Novadriann/PKM---Margorejo/DESIGN MEKANIS/margorejo-Assembly final.step

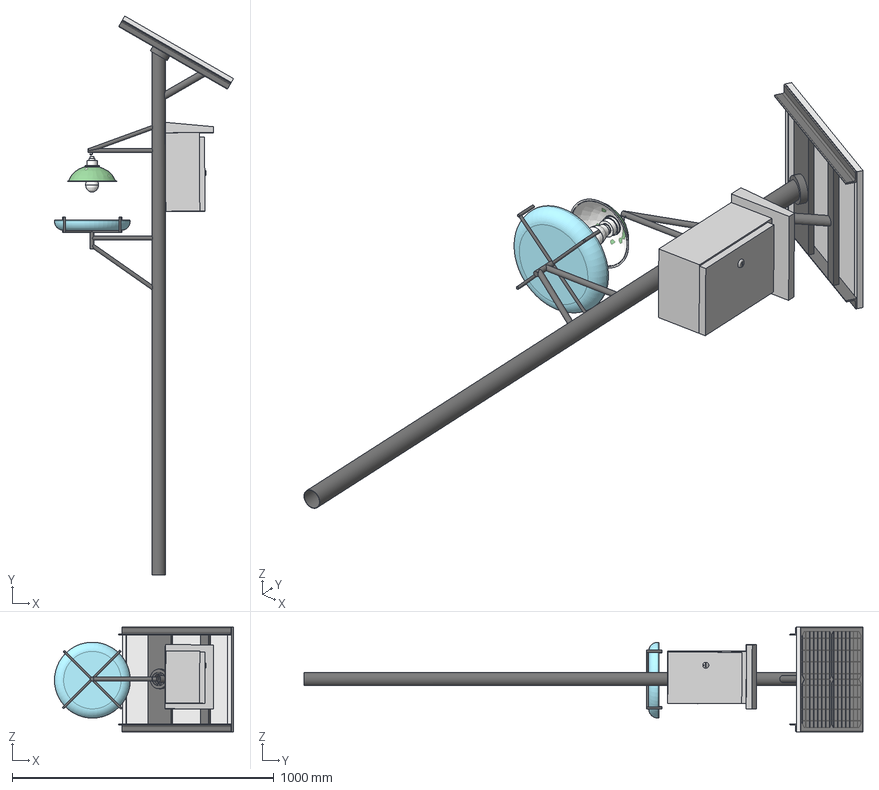
[picture p1: CAD file, 2026-10-15]
DESIGN MEKANIS/margorejo-Assembly final.step
684.8 x 2137.5 x 400.0 mm
tiang
ISO 657-1 - L30x30x4-480
ISO 657-1 - L30x30x4-480_1
ISO 1035/3 - 35 x 15 - 340
ISO 1035/3 - 100 x 15 - 340
Solar panel
ISO 12633-2 - 26.9 x 2.6 - 200
