Novadriann/PKM---Margorejo/DESIGN MEKANIS/margorejo-Mounting Cable Gland.stp

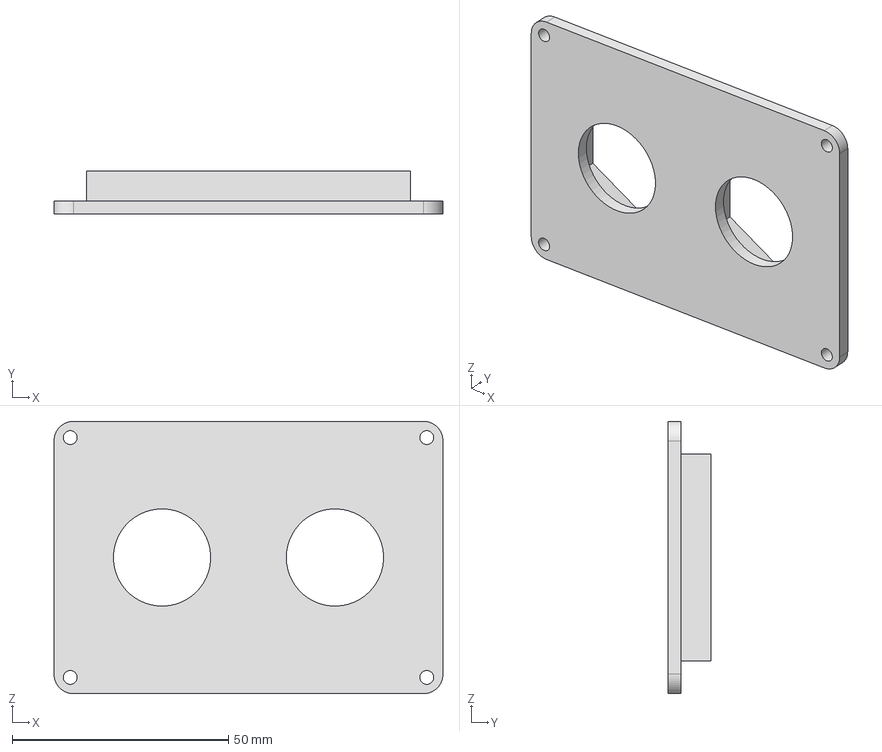
[picture p2: CAD file, 2026-10-15]
DESIGN MEKANIS/margorejo-Mounting Cable Gland.stp
90.0 x 10.0 x 63.0 mm
