Novadriann/PKM---Margorejo/DESIGN MEKANIS/margorejo_Dudukan Aki.step

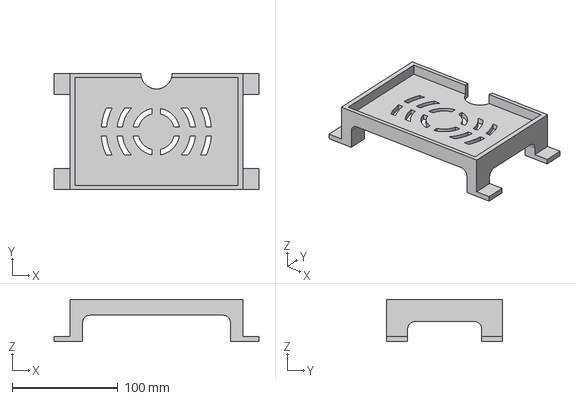
[picture p3: CAD file, 2026-10-15]
DESIGN MEKANIS/margorejo_Dudukan Aki.step
194.0 x 110.0 x 40.0 mm
