Novadriann/PKM---Margorejo/DESIGN MEKANIS/margorejo-Cover Soil Moisture.stl

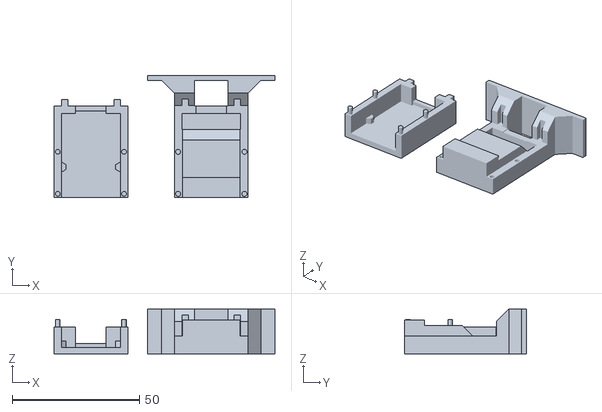
[picture p4: CAD file, 2026-10-15]
DESIGN MEKANIS/margorejo-Cover Soil Moisture.stl
86.7 x 48.0 x 17.6
