Novadriann/PKM---Margorejo/DESIGN MEKANIS/margorejo-Mounting PCB.step

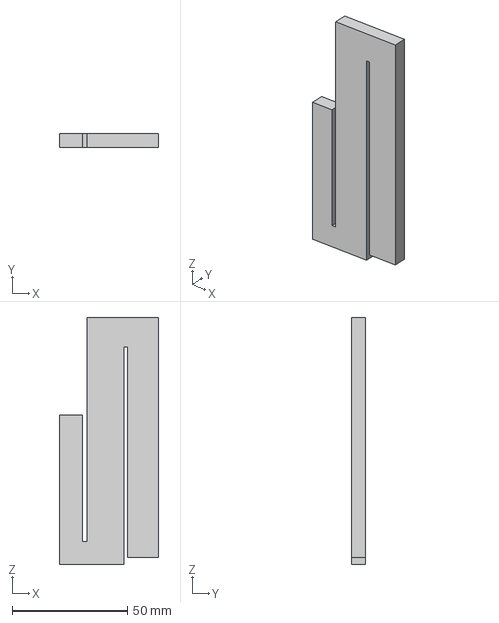
[picture p5: CAD file, 2026-10-15]
DESIGN MEKANIS/margorejo-Mounting PCB.step
43.0 x 6.00 x 107.0 mm
