Novadriann/PKM---Margorejo/DESIGN MEKANIS/margorejo-Mounting INA226.stl

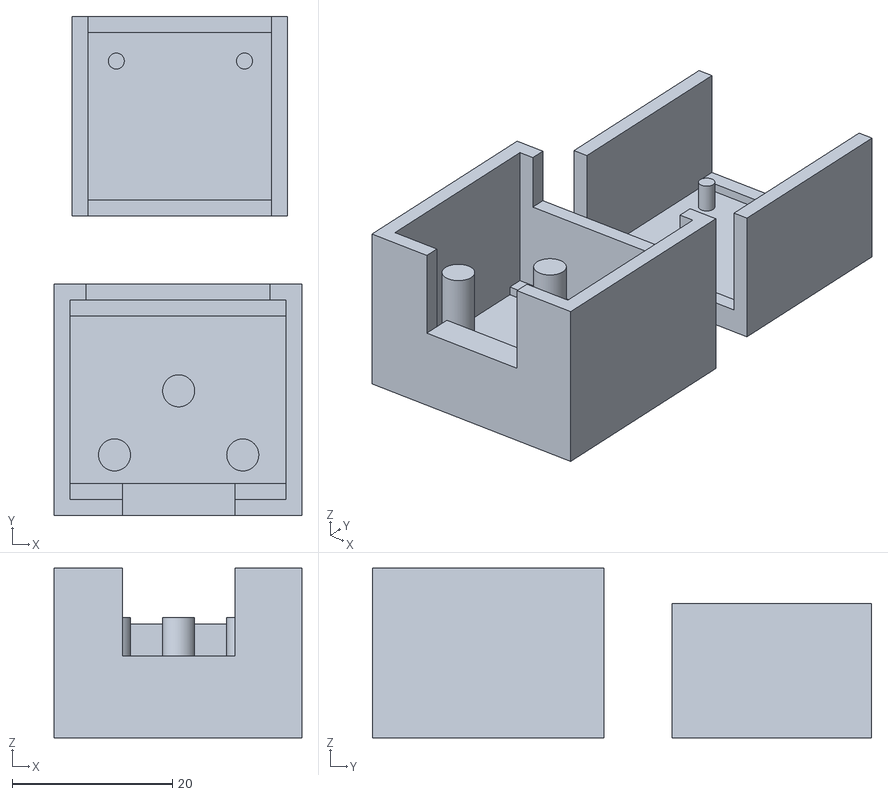
[picture p6: CAD file, 2026-10-15]
DESIGN MEKANIS/margorejo-Mounting INA226.stl
30.9 x 62.3 x 21.2
