Novadriann/PKM---Margorejo/DESIGN MEKANIS/margorejo-Mounting DHT.stl

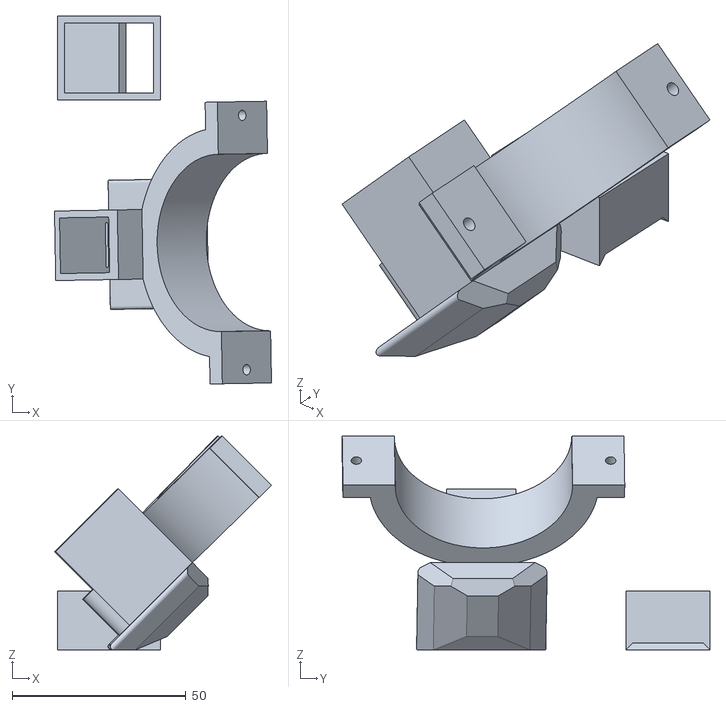
[picture p7: CAD file, 2026-10-15]
DESIGN MEKANIS/margorejo-Mounting DHT.stl
62.4 x 105.8 x 61.5
