Novadriann/PKM---Margorejo/(list of files, cad)

Other CAD files:
DESIGN MEKANIS/Margorejo_Clamp_A2L.gcode.3mf
