Novadriann/PKM---Margorejo/Buku_Panduan_Wiring_NURTURE_Margorejo.docx

PROGRAM PENGABDIAN KEPADA MASYARAKAT (PKM) 2026
UNIVERSITAS GADJAH MADA — MARGOREJO, SLEMAN

BUKU PANDUAN TEKNIS & WIRING
SISTEM PERTANIAN CERDAS MANDIRI ENERGI
"NURTURE"

Pedoman Operasional, Integrasi Catu Daya Bertingkat, Perkabelan Sensor, dan Perawatan Mandiri untuk Petani & Teknisi Lapangan

Parameter | Keterangan
Nama Sistem | NURTURE: Smart Agriculture Mandiri Energi Berbasis IoT & Web
Lokasi Kegiatan | Lahan Pertanian Kalurahan Margorejo, Kapanewon Tempel, Sleman, D.I. Yogyakarta
Dosen Pembimbing | Nur Achmad Sulistyo Putro, S.Si., M.Cs., Ph.D.
Platform Pengendali | ESP32-S3 DevKitC-1 N16R8V Dual Type-C (Dual-Core 240MHz, Wi-Fi/BLE)

BAB I. PENGENALAN ARSITEKTUR SISTEM & DESAIN PCB BERTINGKAT

Sistem NURTURE dirancang secara khusus untuk bekerja secara mandiri (off-grid) di area persawahan Margorejo yang minim jangkauan listrik PLN. Agar sistem memiliki daya tahan tinggi terhadap gangguan lingkungan, interferensi elektromagnetik, dan cuaca ekstrem, perangkat keras pengendali dibangun menggunakan konsep PCB Bertingkat (Stack PCB Architecture) 2 Tingkat.

1.1 Filosofi dan Alasan Desain PCB Bertingkat (Dual-Tier)

Di dalam kotak panel kendali pertanian terdapat dua jenis perangkat dengan karakteristik listrik yang sangat bertolak belakang:
1. Perangkat Logika & Sensor Mikro: Membutuhkan tegangan stabil (3.3V dan 5V), arus sangat kecil, dan sensitif terhadap noise listrik.
2. Perangkat Daya & Aktuator Beban: Membutuhkan arus besar (tegangan 12V DC), menarik arus hentakan saat menyala (seperti motor kipas, relay, dan solenoid valve), serta menghasilkan tegangan kejut balik (back-EMF).

Jika kedua kelompok komponen ini diletakkan pada satu keping PCB biasa, hentakan listrik dari pompa/valve akan langsung mengacaukan pembacaan sensor tanah atau menyebabkan chip mikrokontroler hang/restart (dikenal sebagai fenomena Brownout). Oleh karena itu, sistem memisahkan fisiknya menjadi dua tingkat:

💡 INFORMASI TEKNIS: Mengapa PCB Dibagi Menjadi Dua Tingkat?
Tingkat Bawah (Lower Tier) dikhususkan sebagai Regulator & Jalur Daya Arus Tinggi (12V, 5V, 3.3V).
Tingkat Atas (Upper Tier) dikhususkan sebagai Pusat Pemrosesan Data & Antarmuka Sensor Mikro.
Pemisahan ini menjamin kestabilan modul ESP32-S3 dan sensor NPK 7-in-1 dari gangguan motorik aktuator.

1.2 PCB Tingkat Bawah (Lower Tier — Power & Step-Down Board)

PCB tingkat bawah berfungsi sebagai 'jantung distribusi energi' yang menerima arus listrik DC dari Baterai VRLA 12V 12Ah yang diisi oleh Panel Surya (PLTS) melalui Solar Charge Controller (SCC). Di tingkat bawah ini terpasang modul-modul penurun tegangan (Step-Down DC-DC):
• Jalur Rel 12V DC: Menyalurkan listrik langsung dari baterai ke aktuator berat (Solenoid Valve 12V, Lampu UV Trap 12V, dan Kipas 12V).
• Jalur Rel 5V DC (Step-Down 12V ke 5V): Mengubah 12V baterai menjadi 5V teregulasi (kapasitas 3A) untuk mencatu pin 5V ESP32-S3, modul konverter MAX485 RS485, modul koil relay, dan sensor DHT22.
• Jalur Rel 3.3V DC (Step-Down 12V ke 3.3V): Menyediakan tegangan kerja murni 3.3V untuk pin logika sensitif.
• Titik Common Ground (GND Bersama): Seluruh kutub negatif (GND) dari 12V, 5V, dan 3.3V diikat menjadi satu bidang ground bersama (star ground) agar referensi tegangan tidak melayang.

1.3 PCB Tingkat Atas (Upper Tier — Controller & Sensor Interface)

PCB tingkat atas berfungsi sebagai 'otak dan pusat saraf' pengendali otomatisasi. Komponen-komponen utama yang terpasang di PCB atas meliputi:
• Soket Mikrokontroler ESP32-S3 DevKitC-1 N16R8V (16MB Flash, 8MB PSRAM).
• IC / Modul Transceiver RS485 (U2 - MAX485) untuk membaca protokol industri Modbus RTU pada sensor NPK 7-in-1.
• Tiga Unit Driver Transistor NPN (Q1, Q2, Q3) beserta resistor basis 2kΩ (R1, R2, R3) sebagai sakelar penyala relay.
• Deretan Soket Terminal Sensor: JST-XH dan Screw Terminal untuk Sensor NPK, 3x Probe Kelembapan Tanah, 3x Sensor DHT22, Sensor Cahaya LDR, dan RTC DS3231.
• Soket Interkoneksi Daya Vertikal: Menerima rel 12V, 5V, dan 3.3V dari PCB tingkat bawah.

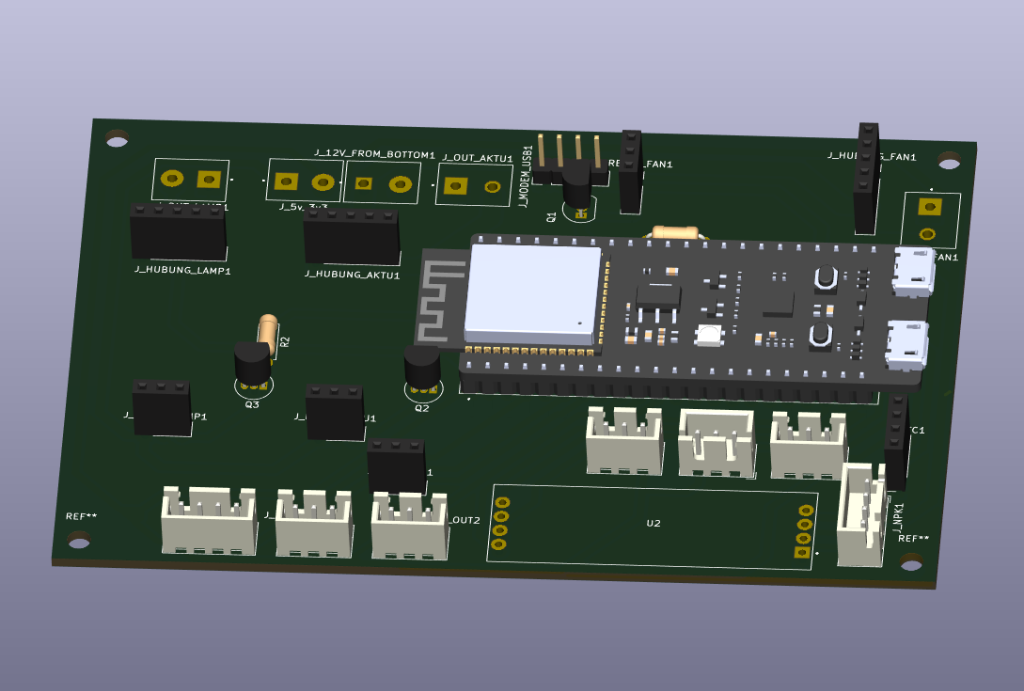
[picture p8: figure]

Gambar 1.1: Visualisasi 3D PCB Tingkat Atas (Main Controller & Sensor Interface Board)

BAB II. PANDUAN WIRING & TERMINAL KONEKTOR PCB ATAS

Bab ini memandu secara rinci letak setiap konektor, nomor pin, warna kabel standar, serta fungsi sambungannya ke perangkat luar. Pastikan teknisi lapangan atau kelompok tani membaca tabel ini sebelum mencolokkan kabel sensor atau beban.

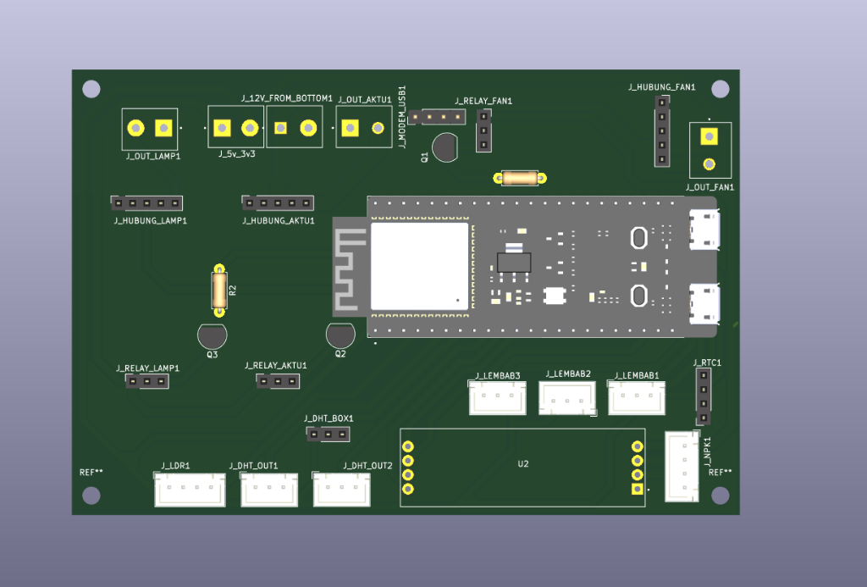
[picture p9: figure]

Gambar 2.1: Tata Letak Konektor dan Silkscreen PCB Tingkat Atas (Tampak Atas)

2.1 Tabel Konektor Interkoneksi Daya (Dari PCB Bawah ke Atas)

Tegangan kerja didistribusikan dari PCB tingkat bawah melalui dua blok konektor vertikal:

Nama Konektor | Pin | Nama Sinyal | Tegangan | Keterangan Fungsi
J_12V_FROM_BOTTOM1 | Pin 1 | +12V | +12 Volt DC | Masukan daya utama dari Baterai PLTS (tingkat bawah)
J_12V_FROM_BOTTOM1 | Pin 2 | GND | 0 Volt (Ground) | Kutub negatif / Ground daya utama
J_5v_3v3 | Pin 1 | +5V | +5.0 Volt DC | Keluaran Step-Down 5V dari tingkat bawah (untuk ESP & Sensor)
J_5v_3v3 | Pin 2 | +3V3 | +3.3 Volt DC | Keluaran Step-Down 3.3V dari tingkat bawah
J_5v_3v3 | Pin 3 | GND | 0 Volt (Ground) | Jalur Ground logika bersama
J_5v_3v3 | Pin 4 | GND | 0 Volt (Ground) | Jalur Ground logika bersama (paralel)

2.2 Tabel Konektor Sensor Tanah, Nutrisi, dan Lingkungan

Seluruh sensor pertanian dihubungkan ke deretan konektor putih di sisi bawah dan kanan PCB:

Kode Soket | Pin | Nama Jalur | GPIO ESP32 | Keterangan & Warna Kabel Standar
J_NPK1 | Pin 1 | VCC (+5V/12V) | — | Catu daya sensor NPK 7in1 (Kabel COKELAT)
J_NPK1 | Pin 2 | GND | — | Kutub negatif sensor NPK (Kabel HITAM)
J_NPK1 | Pin 3 | RS485 A (+) | Via IC U2 | Data Modbus Positif / Non-Inverting (Kabel KUNING)
J_NPK1 | Pin 4 | RS485 B (-) | Via IC U2 | Data Modbus Negatif / Inverting (Kabel BIRU)
J_LEMBAB1 | 1, 2, 3 | VCC, OUT, GND | GPIO 10 (ADC) | Probe Kelembapan Tanah Analog 1 (Kapasitif)
J_LEMBAB2 | 1, 2, 3 | VCC, OUT, GND | GPIO 11 (ADC) | Probe Kelembapan Tanah Analog 2 (Kapasitif)
J_LEMBAB3 | 1, 2, 3 | VCC, OUT, GND | GPIO 12 (ADC) | Probe Kelembapan Tanah Analog 3 / Cadangan
J_DHT_BOX1 | 1, 2, 3 | VCC, DATA, GND | GPIO 7 | Sensor DHT22 Suhu & Kelembapan Kotak Panel
J_DHT_OUT1 | 1, 2, 3 | VCC, DATA, GND | GPIO 6 | Sensor DHT22 Cuaca Lingkungan Luar 1
J_DHT_OUT2 | 1, 2, 3 | VCC, DATA, GND | GPIO 16 | Sensor DHT22 Cuaca Lingkungan Luar 2
J_LDR1 | 1, 2, 3, 4 | VCC, OUT, GND | GPIO 4 (ADC) | Sensor Cahaya Matahari LDR (Intensitas Radiasi)
J_RTC1 | 1, 2 | VCC, GND | — | Catu daya Modul DS3231 Waktu Presisi (5V)
J_RTC1 | Pin 3 | SDA (Data I2C) | GPIO 8 | Jalur data I2C RTC DS3231
J_RTC1 | Pin 4 | SCL (Clock I2C) | GPIO 9 | Jalur clock I2C RTC DS3231

⚠️ PERINGATAN KESELAMATAN: Kabel Modbus RS485 Sensor NPK 7-in-1
Warna kabel standar pabrik sensor NPK 7in1 adalah:
• Cokelat: VCC (+5V / +12V)
• Hitam: GND (Ground)
• Kuning: Pin A (RS485+)
• Biru: Pin B (RS485-)
JANGAN SAMPAI TERBALIK antara kabel A (Kuning) dan B (Biru) karena akan menyebabkan kode error pembacaan NPK di layar monitor.

2.3 Rangkaian Penggerak Aktuator (Driver Transistor & Relay)

Untuk melindungi ESP32-S3 dari tarikan arus koil relay dan lonjakan tegangan, PCB atas dilengkapi sirkuit sakelar transistor NPN (BJT). Pin GPIO mikrokontroler tidak menyalakan relay secara langsung, melainkan mengalirkan arus kecil melalui resistor 2kΩ ke basis transistor, yang kemudian men-trigger jalur relay eksternal.

Aktuator Beban | Pin GPIO ESP32 | Resistor & Transistor | Header ke Modul Relay | Terminal Daya Output
Kipas Pendingin Kotak (Fan) | GPIO 39 | R1 (2kΩ) & Q1 (NPN) | J_RELAY_FAN1 (3 Pin) | J_OUT_FAN1 & J_HUBUNG_FAN1 (12V)
Lampu UV Perangkap Hama | GPIO 15 | R2 (2kΩ) & Q3 (NPN) | J_RELAY_LAMP1 (3 Pin) | J_OUT_LAMP1 & J_HUBUNG_LAMP1 (12V)
Solenoid Valve (Penyiraman) | GPIO 5 | R3 (2kΩ) & Q2 (NPN) | J_RELAY_AKTU1 (3 Pin) | J_OUT_AKTU1 & J_HUBUNG_AKTU1 (12V)

2.4 Skematik Elektronika Lengkap (KiCad)

Berikut adalah gambar skema pengkabelan elektronik menyeluruh dari sistem PCB tingkat atas yang dirancang menggunakan KiCad EDA (pengabdian.kicad_sch):

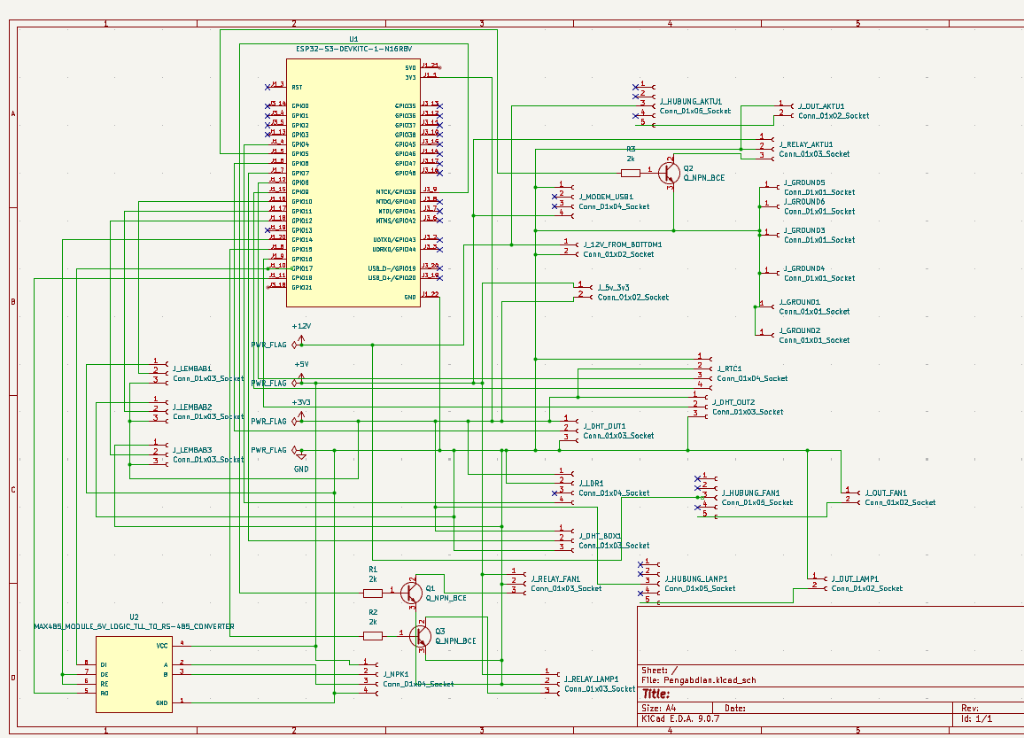
[picture p10: figure]

Gambar 2.2: Skematik Sirkuit Elektronika Lengkap PCB Tingkat Atas (KiCad EDA)

BAB III. SISTEM CATU DAYA MANDIRI ENERGI (PLTS & PCB BAWAH)

Sistem NURTURE beroperasi sepenuhnya menggunakan energi terbarukan tenaga surya. Stabilitas operasional sangat bergantung pada kualitas perakitan kelistrikan dari panel surya hingga masuk ke PCB tingkat bawah.

3.1 Diagram Alur Energi Listrik Sistem

1. Panel Surya (Photovoltaic): Mengonversi radiasi sinar matahari menjadi energi listrik DC.
2. Solar Charge Controller (SCC): Mengatur pengisian daya baterai (mencegah overcharge saat siang dan overdischarge saat malam).
3. Baterai VRLA 12V 12Ah: Menyimpan cadangan energi yang sanggup menghidupkan seluruh sistem selama lebih dari 3 hari berawan/hujan tanpa matahari.
4. Sensor Arus Dual INA226 (I2C):
• Modul 1 (Alamat I2C 0x44): Mengukur arus dan daya pengisian dari SCC ke Baterai (Charging Current).
• Modul 2 (Alamat I2C 0x45): Mengukur arus dan konsumsi daya aktual yang ditarik oleh seluruh sistem (Load Current).
5. PCB Tingkat Bawah (Regulator Board): Mengambil input 12V dari baterai dan memecahnya menjadi rel 12V, 5V, dan 3.3V.
6. PCB Tingkat Atas: Menerima tegangan bersih untuk ESP32-S3 dan sensor.

3.2 Konfigurasi Modul Step-Down di PCB Tingkat Bawah

Di PCB tingkat bawah dipasang modul regulator efisiensi tinggi (Buck Converter DC-DC, misalnya tipe LM2596 atau XL4015):
• Modul Step-Down 5V: Disetel tepat pada tegangan keluaran 5.05V - 5.10V DC. Modul ini wajib mampu mengeluarkan arus konstan minimal 2.5 hingga 3.0 Ampere. Arus ini diperlukan saat ESP32-S3 memancarkan sinyal radio Wi-Fi sambil mengaktifkan relay.
• Modul Step-Down 3.3V: Disetel tepat pada tegangan keluaran 3.30V DC untuk keperluan suplai logika sensor bertegangan rendah.

⚠️ PERINGATAN KESELAMATAN: Pedoman Pemasangan Kabel Power (Mencegah Kebakaran & Drop Tegangan)
1. Gunakan kabel serabut tembaga tebal (minimal ukuran AWG 18-20 atau penampang 0.75 mm²) untuk menghubungkan aki, SCC, dan input PCB bawah. Jangan pernah menggunakan kabel jumper tipis untuk jalur daya utama!
2. Pasang Fuse / Sekring Pengaman DC (tipe tabung kaca atau sekring tancap otomotif ukuran 3A - 5A) pada kutub positif kabel aki menuju sistem sebagai proteksi korsleting.
3. Pastikan baut terminal aki dan terminal blok PCB terkunci rapat. Baut kendor dapat menimbulkan percikan api dan membuat tegangan drop.

BAB IV. LOGIKA OPERASIONAL & ATURAN OTOMASI SISTEM

Seluruh keputusan otomatisasi dikerjakan secara mandiri di dalam chip ESP32-S3 setiap detik tanpa memerlukan koneksi internet (sistem tetap menyiram dan menyalakan lampu meskipun jaringan Wi-Fi sedang terputus).

4.1 Otomasi Penyiraman Lahan (Smart Solenoid Valve)

Penyiraman tanaman dilakukan secara terjadwal berdasarkan jam presisi dari modul RTC DS3231:
• Jadwal Pagi: Solenoid valve terbuka otomatis tepat pada pukul 07:00:00 WIB dan menyiram selama 10 menit hingga pukul 07:10:00 WIB.
• Jadwal Sore: Solenoid valve terbuka otomatis tepat pada pukul 17:20:00 WIB dan menyiram selama 10 menit hingga pukul 17:30:00 WIB.
• Proteksi Batas Maksimum (Safety Timeout 15 Menit): Sistem dilengkapi fail-safe otomatis. Jika karena suatu gangguan program atau sensor valve menyala lebih dari 15 menit, mikrokontroler akan memutus daya valve secara paksa untuk mencegah kebanjiran lahan atau terbakarnya kumparan solenoid valve.

4.2 Otomasi Kipas Pendingin Boks Panel (Smart Cooling Fan)

Boks panel yang diletakkan di tengah sawah terbuka sangat rentan mengalami panas berlebih akibat terik matahari. Sistem melindungi komponen elektronik dengan aturan berikut:
• Ambang Batas Suhu: Sensor DHT22 dalam boks memantau suhu secara kontinu. Jika suhu dalam panel mencapai atau melebihi 34.0 °C, kipas exhaust langsung dinyalakan.
• Durasi Siklus: Kipas akan berputar selama 5 menit (300 detik) untuk menguras udara panas keluar boks, lalu mati otomatis.
• Siklus Ulang: Setelah mati, sistem mengecek kembali suhu boks. Jika suhu masih di atas 34 °C, kipas akan melanjutkan pendinginan pada siklus berikutnya hingga suhu boks benar-benar aman.

4.3 Otomasi Lampu Perangkap Hama (UV Light Trap)

Lampu ultraviolet penarik serangga hama sawah dikendalikan otomatis berbasis jam malam (RTC DS3231):
• Menyala otomatis pada pukul 18:00 WIB (petang/saat matahari terbenam).
• Mati otomatis pada pukul 06:00 WIB (pagi hari).
• Operasi ini ramah lingkungan karena menekan populasi hama nocturnal tanpa pestisida kimia berlebih.

4.4 Pengiriman Data Nirkabel (Telemetri UDP & Cloud Dashboard)

Sistem memisahkan jalur pemantauan menjadi dua kanal:
1. Telemetri Real-Time Lokal (UDP Broadcast Port 4210): ESP32 memancarkan data mentah seluruh sensor setiap 1 detik sekali ke jaringan Wi-Fi lokal. Sangat berguna untuk teknisi memeriksa kondisi alat secara instan menggunakan laptop di lapangan.
2. Cloud Dashboard ThingSpeak & Web: Data diunggah ke server cloud setiap 16 detik sekali agar grafik kondisi nutrisi tanah, suhu sawah, dan cadangan baterai PLTS dapat dipantau oleh petani dari mana saja lewat smartphone.

BAB V. PANDUAN TROUBLESHOOTING & PERAWATAN MANDIRI

Petani atau pengurus kelompok tani (Poktan) dapat melakukan pemeriksaan awal dan penanganan mandiri jika terjadi kejanggalan pada sistem menggunakan panduan tabel berikut:

5.1 Tabel Diagnosa Masalah Lapangan (Troubleshooting)

Gejala Masalah | Kemungkinan Penyebab | Cara Pemeriksaan | Tindakan Perbaikan
Lampu LED ESP32 redup, berkedip ngaco, atau data ThingSpeak macet. | Tegangan 5V drop akibat tarikan arus aktuator (Brownout). | Ukur tegangan pada pin 5V ESP32 menggunakan multimeter saat relay aktif. | Putar potensio modul step-down 5V di PCB bawah agar tepat 5.1V. Pastikan kabel aki kencang.
Data NPK di layar bernilai 0 atau 'ERROR MODBUS'. | Kabel data RS485 A dan B terbalik, longgar, atau kabel sensor putus. | Periksa soket J_NPK1. Cek apakah kabel kuning (A) dan biru (B) terpasang benar. | Tukar posisi kabel A dan B pada soket J_NPK1. Periksa sambungan kabel sensor di dalam tanah.
Air tidak mengalir keluar saat jam penyiraman tiba. | Tandon air kosong, filter pipa tersumbat lumut, atau solenoid valve macet. | Dengarkan apakah ada suara 'klik' dari relay pada pukul 07:00 atau 17:20. | Jika relay berbunyi klik namun air tidak keluar, periksa tandon air dan bersihkan klep valve.
Jadwal penyiraman atau lampu menyala di waktu yang salah. | Waktu pada modul RTC DS3231 reset atau baterai koin CR2032 habis. | Lihat tampilan jam di layar web dashboard apakah sesuai dengan jam dinding saat ini. | Ganti baterai koin CR2032 pada modul RTC, lalu lakukan sinkronisasi waktu jam via kode.
Kipas boks tidak mau menyala padahal boks terasa panas menyengat. | Sensor DHT22 kotak panel kendor atau suhu belum menyentuh batas 34 °C. | Cek pembacaan 'Suhu Dalam' di dashboard web apakah sudah melewati angka 34.0 °C. | Kencangkan soket J_DHT_BOX1. Cek kabel kipas 12V di terminal J_OUT_FAN1.
Grafik arus baterai bernilai negatif (-) di siang hari. | Arah pembacaan modul INA226 terbalik atau baterai sedang menyuplai beban. | Lihat apakah panel surya tertutup dedaunan/kotoran burung sehingga pengisian lemah. | Bersihkan permukaan panel surya dari debu dan kotoran agar arus charging kembali positif.

5.2 Jadwal Pemeliharaan Rutin Perangkat

Untuk menjaga umur pakai sistem hingga bertahun-tahun, kelompok tani disarankan menjalankan perawatan berkala:

1. Pemeliharaan Mingguan:
• Bersihkan kaca Panel Surya menggunakan kain basah dari debu tanah sawah dan kotoran burung.
• Periksa kebersihan saringan/filter air sebelum masuk ke Solenoid Valve agar pasir tidak mengganjal klep.
• Bersihkan wadah penampung serangga pada Lampu UV Trap.

2. Pemeliharaan Bulanan:
• Buka kotak panel kendali, periksa apakah ada serangga/semut yang bersarang di sela-sela PCB.
• Periksa kekencangan baut terminal aki dan konektor kabel daya.
• Periksa lubang ventilasi dan bersihkan debu yang menempel pada bilah kipas pendingin.

3. Pemeliharaan Setiap Musim Tanam:
• Cabut dan bersihkan probe stainless steel sensor NPK 7-in-1 dari kerak tanah kering atau sisa pupuk.
• Periksa tegangan Baterai VRLA saat sore hari tanpa beban (tegangan sehat berada di atas 12.6V DC).
• Periksa kondisi baterai koin CR2032 pada modul RTC DS3231.

💡 INFORMASI TEKNIS: Layanan Bantuan Teknis
Jika ditemukan kerusakan fisik pada papan sirkuit PCB atau kegagalan transmisi data yang tidak dapat diselesaikan melalui buku panduan ini, silakan hubungi Tim Pengabdian Masyarakat UGM atau pengelola teknis Poktan Margorejo.

BAB VI. PANDUAN HARD PROGRAMMER (FIRMWARE & GITHUB REPOSITORY)

Bab ini ditujukan khusus bagi teknisi pengembang perangkat lunak embedded (Hard Programmer) yang bertanggung jawab atas instalasi, pembaruan (flashing), penyesuaian parameter, dan pemeliharaan kode sumber firmware ESP32-S3 pada sistem NURTURE.

6.1 Tutorial Mengunduh Kode Sumber dari Repositori GitHub

Seluruh kode sumber terbaru, skrip pengujian UDP, pustaka skematik, serta dokumentasi sistem tersimpan secara terpusat pada repositori GitHub resmi tim pengabdian:
🔗 URL Repositori: https://github.com/Novadriann/PKM---Margorejo

Terdapat dua metode untuk mengunduh kode program ke komputer kerja:

Metode 1: Mengunduh File ZIP Langsung (Paling Mudah Tanpa Git)
1. Buka tautan https://github.com/Novadriann/PKM---Margorejo melalui peramban web (Google Chrome / Firefox / Edge).
2. Klik tombol hijau bertuliskan '<> Code' yang berada di bagian kanan atas daftar file.
3. Pada menu dropdown yang muncul, pilih opsi 'Download ZIP'.
4. Setelah proses unduhan selesai, klik kanan file ZIP tersebut lalu pilih 'Extract All...' (Ekstrak Semua) ke folder kerja di komputer (contoh: C:\PKM Margorejo\).
5. Folder hasil ekstraksi siap dibuka langsung menggunakan Arduino IDE.

Metode 2: Menggunakan Git Command Line (Untuk Programmer/Developer)
Buka terminal Command Prompt (CMD) atau PowerShell, lalu jalankan perintah kloning berikut:
git clone https://github.com/Novadriann/PKM---Margorejo.git
Folder repositori akan otomatis terunduh lengkap dengan riwayat komit pengembangannya.

6.2 Struktur Direktori & Fungsi Berkas Repositori

Berikut adalah peta struktur berkas kode program yang terdapat di dalam repositori:

Nama Berkas / Direktori | Kategori | Deskripsi & Peran dalam Sistem
KODE_ESP_NODE1_SEMOGASUDAHFIX/ | Firmware Node 1 | Kode Arduino IDE untuk Stasiun 1: Membaca NPK, RTC, mengontrol Solenoid Valve, Kipas, dan Lampu UV.
KODE_ESP_NODE2_SEMOGASUDAHFIX/ | Firmware Node 2 | Kode Arduino IDE untuk Stasiun 2: Membaca NPK, pemantauan baterai INA226 (arus positif saat charging), dan Kipas.
cek_udp.py | Script Python | Alat monitoring telemetri real-time di laptop teknisi tanpa butuh internet (menangkap siaran UDP port 4210).
Buku_Panduan_Wiring_NURTURE_Margorejo.docx | Dokumentasi | Buku panduan teknis dan wiring lengkap untuk petani dan teknisi lapangan.
save_data.py & platformio.ini | Tooling | Konfigurasi pendukung PlatformIO dan penyimpanan log telemetri.

6.3 Konfigurasi Board ESP32-S3 pada Arduino IDE

Sebelum mengunggah kode, pastikan Arduino IDE telah terpasang board support 'esp32 by Espressif Systems' dan pustaka (library) yang dibutuhkan telah diinstal melalui menu Tools -> Manage Libraries:
• RTClib (oleh Adafruit): Pengelolaan kalender dan waktu presisi modul DS3231 via I2C.
• DHT sensor library (oleh Adafruit): Pembacaan suhu dan kelembapan sensor DHT22.
• ModbusMaster (oleh Doc Walker / 4-20ma): Penanganan protokol Modbus RTU RS485 sensor NPK.
• INA226_WE (oleh Wolfgang Ewald): Pembacaan presisi arus, tegangan, dan daya PLTS via I2C.

Pengaturan Board Menu 'Tools' pada Arduino IDE wajib disesuaikan sebagai berikut:

Parameter Pengaturan (Tools) | Nilai Pilihan (Configuration) | Fungsi & Alasan Teknis
Board | ESP32S3 Dev Module | Target chip mikrokontroler ESP32-S3 dual-core.
USB CDC On Boot | Enabled | Mengaktifkan Serial Monitor langsung melalui port USB Type-C bawaan.
Flash Size | 16MB (128Mb) | Sesuai kapasitas memori flash fisik modul N16R8V.
Partition Scheme | 16M Flash (3MB APP/9.9MB FATFS) | Menyediakan ruang alokasi binary program dan sistem file yang besar.
PSRAM | OPI PSRAM | Mengaktifkan memori eksternal 8MB PSRAM tipe Octal.
CPU Frequency | 240MHz (WiFi) | Kecepatan clock maksimal untuk pemrosesan kriptografi HTTPS & Wi-Fi.

6.4 Penjelasan Arsitektur & Logika Kode (Hard Programmer Notes)

Firmware NURTURE ditulis dengan menerapkan standar pemrograman embedded modern untuk menjamin keandalan 24/7:

1. Paradigma Eksekusi Non-Blocking (millis() Scheduling):
Program tidak menggunakan delay() untuk menjaga respon sistem. Seluruh tugas (pembacaan sensor tanah, NPK, RTC, kontrol aktuator, siaran UDP, dan pengiriman HTTPS) dijalankan menggunakan mesin status multi-interval berbasis millis().

2. Manajemen Protokol Modbus RTU RS485 (Sensor NPK 7-in-1):
Komunikasi RS485 ditangani oleh HardwareSerial(1) pada pin GPIO17 (TX), GPIO18 (RX), dan GPIO14 (DIR DE/RE). Fungsi membaca 7 register secara berurutan: Kelembapan (reg 0), Suhu (reg 1), EC (reg 2), pH (reg 3), Nitrogen (reg 4), Fosfor (reg 5), dan Kalium (reg 6). Data EC langsung bertipe integer satuan µS/cm tanpa pembagian skala.

3. Logika Otomasi Terjadwal RTC & Perlindungan Fail-Safe:
• Waktu RTC dibaca tepat 1 kali per detik di loop utama untuk menghindari bentrokan lalu lintas pada bus I2C.
• Penyiraman Solenoid Valve aktif otomatis pada jam 07:00-07:10 (Pagi) dan 17:20-17:30 (Sore) selama 10 menit.
• Fitur Safety Timeout 15 Menit: Jika valve terbuka melebihi 15 menit, mikrokontroler secara otomatis memutus daya valve secara paksa untuk melindungi lahan dari kebanjiran dan melindungi kumparan solenoid dari panas berlebih.

4. Logika Sirkulasi Termal Kipas Boks (Exhaust Fan):
Jika sensor DHT22 dalam boks membaca suhu ≥ 34.0 °C, kipas dinyalakan selama 5 menit. Setelah siklus selesai, sistem mereset status siklus kipas sehingga jika boks masih terpapar panas matahari ekstrem, kipas langsung melanjutkan pendinginan pada siklus berikutnya.

5. Telemetri Ganda (Dual Telemetry Communication):
• Telemetri Lokal (UDP Port 4210): Siaran paket data JSON lengkap setiap 1 detik ke alamat broadcast subnet WiFi. Bebas kuota internet dan dapat dipantau langsung di lapangan menggunakan script cek_udp.py.
• Cloud IoT ThingSpeak: Mengunggah data setiap 16 detik (mendekati batas laju free tier ThingSpeak 15 detik). Pengunggahan dibagi menjadi Channel Utama dan Channel Pendukung berjeda 5 detik guna mencegah fragmentasi memori RAM (Heap exhaustion) saat negosiasi SSL/TLS.

💡 INFORMASI TEKNIS: Catatan Perbedaan Kode Node 1 dan Node 2
• Node 1 (Stasiun Irigasi Utama): Mengendalikan Solenoid Valve pengairan (GPIO 5), Kipas (GPIO 39), Lampu UV (GPIO 15), 2 Probe Analog Tanah, dan Modul NPK 7-in-1.
• Node 2 (Stasiun Monitoring Sekunder): Menangani pembacaan NPK 7-in-1, kontrol Kipas, dan modul INA226 Baterai dengan rumus pembalikan polaritas arus (arus_baterai = -rawI / 1000.0) agar pengisian siang hari terdeteksi positif.

Buku Panduan Teknis Wiring Sistem NURTURE | PKM Margorejo 2026
