Novadriann/PKM---Margorejo/docx_helpers.py

import os
import docx
from docx.shared import Inches, Pt, RGBColor
from docx.enum.text import WD_ALIGN_PARAGRAPH
from docx.enum.table import WD_TABLE_ALIGNMENT, WD_ALIGN_VERTICAL
from docx.oxml import OxmlElement, parse_xml
from docx.oxml.ns import qn, nsdecls

def set_cell_background(cell, fill_hex):
    tcPr = cell._tc.get_or_add_tcPr()
    shd = parse_xml(f'<w:shd {nsdecls("w")} w:fill="{fill_hex}"/>')
    tcPr.append(shd)

def set_cell_margins(cell, top=100, bottom=100, left=150, right=150):
    tcPr = cell._tc.get_or_add_tcPr()
    tcMar = parse_xml(f'<w:tcMar {nsdecls("w")}>'
                      f'<w:top w:w="{top}" w:type="dxa"/>'
                      f'<w:bottom w:w="{bottom}" w:type="dxa"/>'
                      f'<w:left w:w="{left}" w:type="dxa"/>'
                      f'<w:right w:w="{right}" w:type="dxa"/>'
                      f'</w:tcMar>')
    tcPr.append(tcMar)

def set_cell_borders(cell, top="none", bottom="none", left="none", right="none", 
                     color="CCCCCC", sz="4"):
    tcPr = cell._tc.get_or_add_tcPr()
    borders = parse_xml(f'<w:tcBorders {nsdecls("w")}>'
                        f'<w:top w:val="{top}" w:sz="{sz}" w:space="0" w:color="{color}"/>'
                        f'<w:bottom w:val="{bottom}" w:sz="{sz}" w:space="0" w:color="{color}"/>'
                        f'<w:left w:val="{left}" w:sz="{sz}" w:space="0" w:color="{color}"/>'
                        f'<w:right w:val="{right}" w:sz="{sz}" w:space="0" w:color="{color}"/>'
                        f'</w:tcBorders>')
    tcPr.append(borders)

def make_callout(doc, title, text, box_type="info"):
    # box_type: info (green), warning (amber), alert (red)
    border_color = "1E4620" if box_type == "info" else ("D97706" if box_type == "warning" else "DC2626")
    bg_color = "F0FDF4" if box_type == "info" else ("FFFBEB" if box_type == "warning" else "FEF2F2")
    icon = "💡 INFORMASI PENTING:" if box_type == "info" else ("⚠️ PERINGATAN KESELAMATAN:" if box_type == "warning" else "🚨 CATATAN KHUSUS:")
    
    table = doc.add_table(rows=1, cols=1)
    table.alignment = WD_TABLE_ALIGNMENT.CENTER
    table.autofit = False
    cell = table.cell(0, 0)
    cell.width = Inches(6.5)
    
    set_cell_background(cell, bg_color)
    set_cell_margins(cell, top=140, bottom=140, left=200, right=180)
    set_cell_borders(cell, left="single", color=border_color, sz="24")
    
    p = cell.paragraphs[0]
    p.paragraph_format.space_before = Pt(0)
    p.paragraph_format.space_after = Pt(4)
    run_t = p.add_run(f"{icon} {title}\n")
    run_t.bold = True
    run_t.font.name = "Calibri"
    run_t.font.size = Pt(10.5)
    run_t.font.color.rgb = RGBColor.from_string(border_color)
    
    run_b = p.add_run(text)
    run_b.font.name = "Calibri"
    run_b.font.size = Pt(10)
    run_b.font.color.rgb = RGBColor(50, 50, 50)
    
    doc.add_paragraph().paragraph_format.space_after = Pt(4)

print("Helper functions defined successfully")
