Novadriann/PKM---Margorejo/(commit log)

2026-10-13 Tambah kode program Node 1 & Node 2 terbaru, script monitoring UDP, dan Buku Panduan Wiring NURTURE
2026-10-15 Menambahkan file proyek PKM Margorejo
    [Margorejo_Clamp_A2L.gcode.3mf, margorejo-Assembly final.step, margorejo-Cover Soil Moisture.stl, margorejo-Mounting Cable Gland.stp, margorejo-Mounting DHT.stl, margorejo-Mounting INA226.stl, margorejo-Mounting PCB.step, margorejo_Dudukan Aki.step]
2026-10-15 Menambahkan file 3D
    [Margorejo_Clamp_A2L.gcode.3mf, margorejo-Assembly final.step, margorejo-Cover Soil Moisture.stl, margorejo-Mounting Cable Gland.stp, margorejo-Mounting DHT.stl, margorejo-Mounting INA226.stl, margorejo-Mounting PCB.step, margorejo_Dudukan Aki.step]
