Novadriann/PKM---Margorejo/(notices)

Notices in the files:
README.md:
License: MIT
